sig2650/Voltmace-Database-hardware/README.md

# Voltmace-Database-hardware
Schematics, drawings, photos of the Voltmace Database
