sig2650/Voltmace-Database-hardware/Database_schematic_A4.pdf

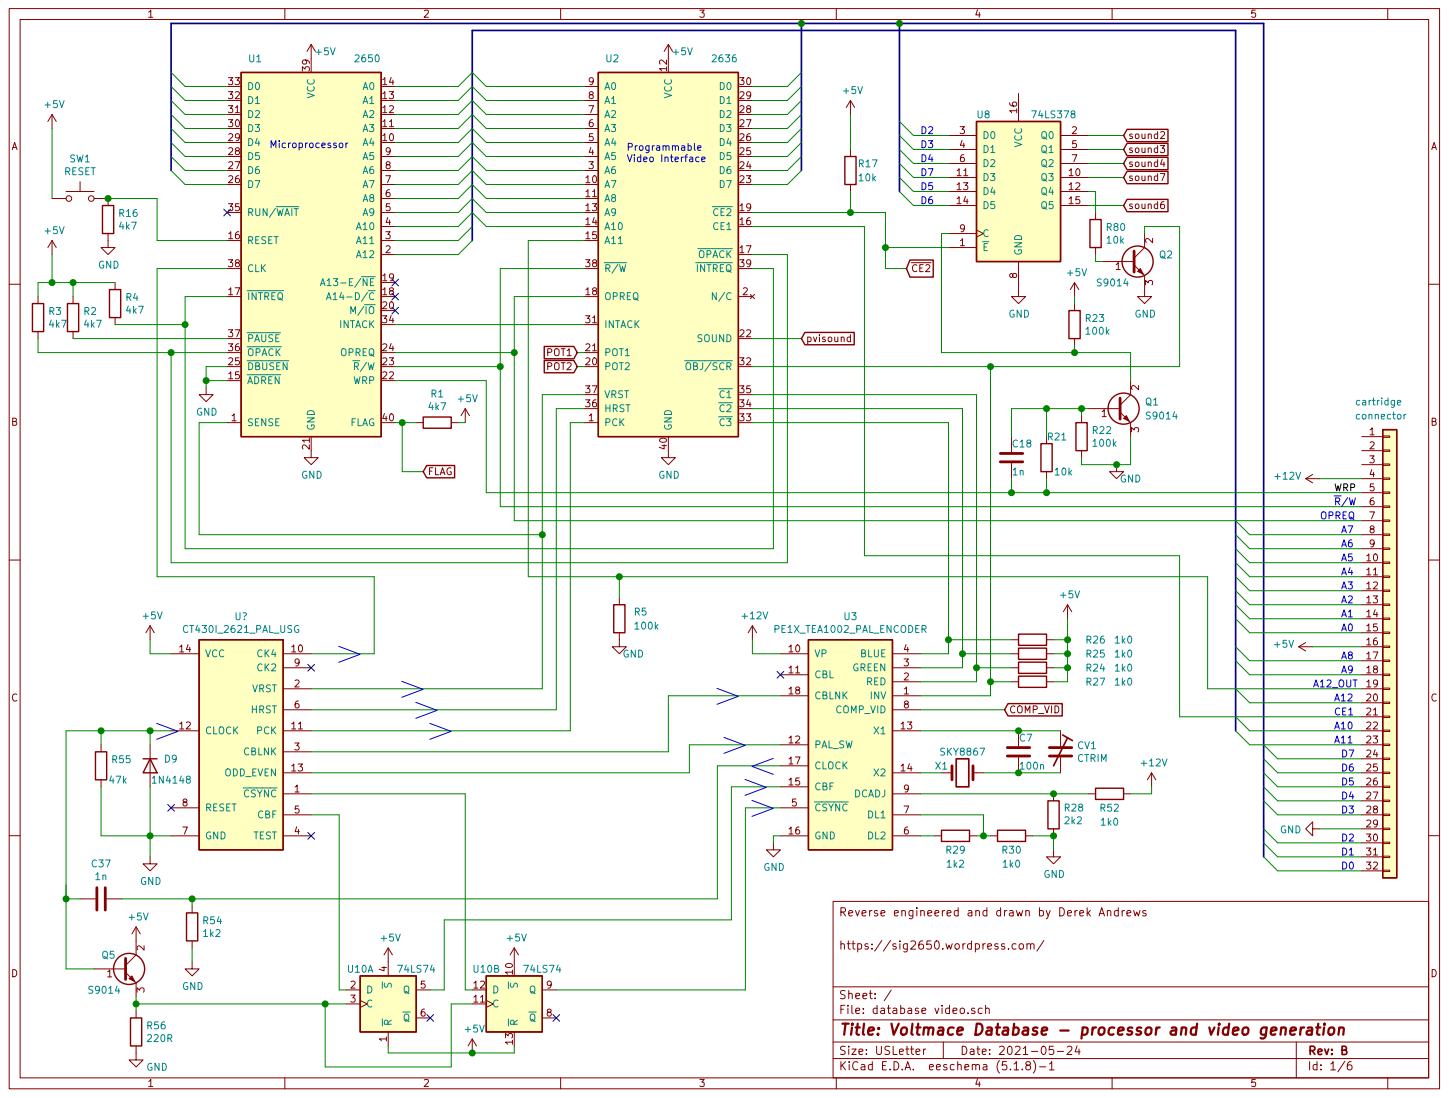
[picture p1: page 1]

Reverse engineered and drawn by Derek Andrews Sheet: Munch&CrunchCart File: munchcrunch.sch Sheet: userI0 File: userIO.sch Sheet: audio & video File: audio_video.sch Sheet: power

A12_OUT D7 R/W A7 A10 CE1 A12A6A5A4D6 8 9 10 11 12 13 14 15 16

File: database video.sch Sheet: / https://sig2650.wordpress.com/

Id: 1/6 Title: Voltmace Database - processor and video generation

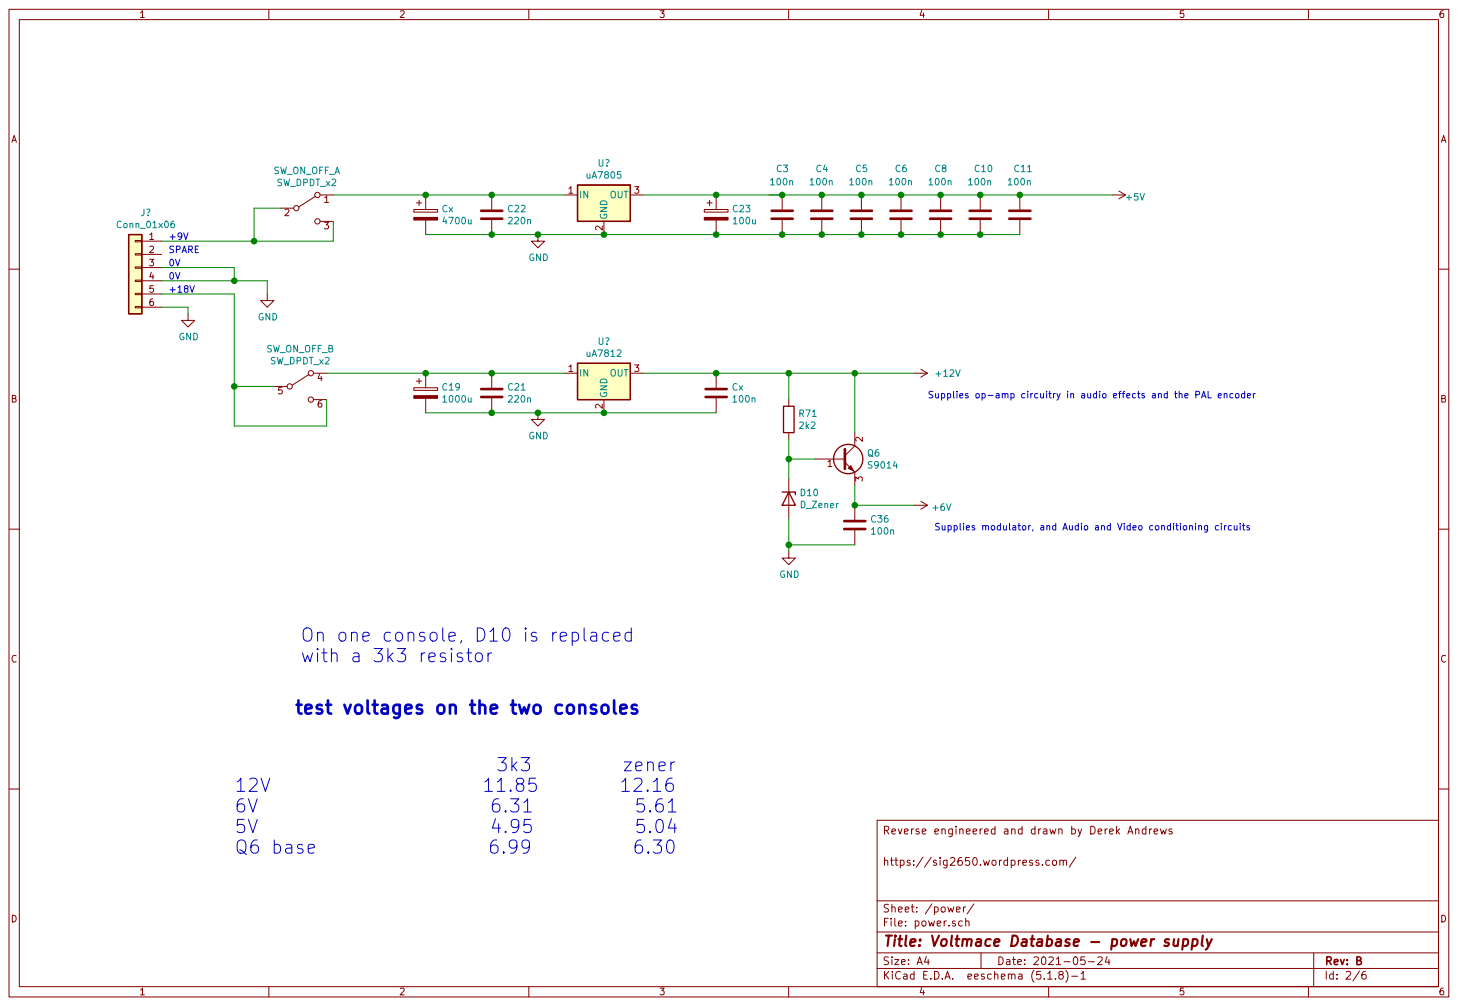
[picture p2: page 2]

Reverse engineered and drawn by Derek Andrews Cx100n GND

Supplies op-amp circuitry in audio effects and the PAL encoder

Supplies modulator, and Audio and Video conditioning circuits

On one console, D10 is replaced
with a 3k3 resistor

test voltages on the two consoles

Sheet: /power/
File: power.sch
Id: 2/6 Title: Voltmace Database - power supply

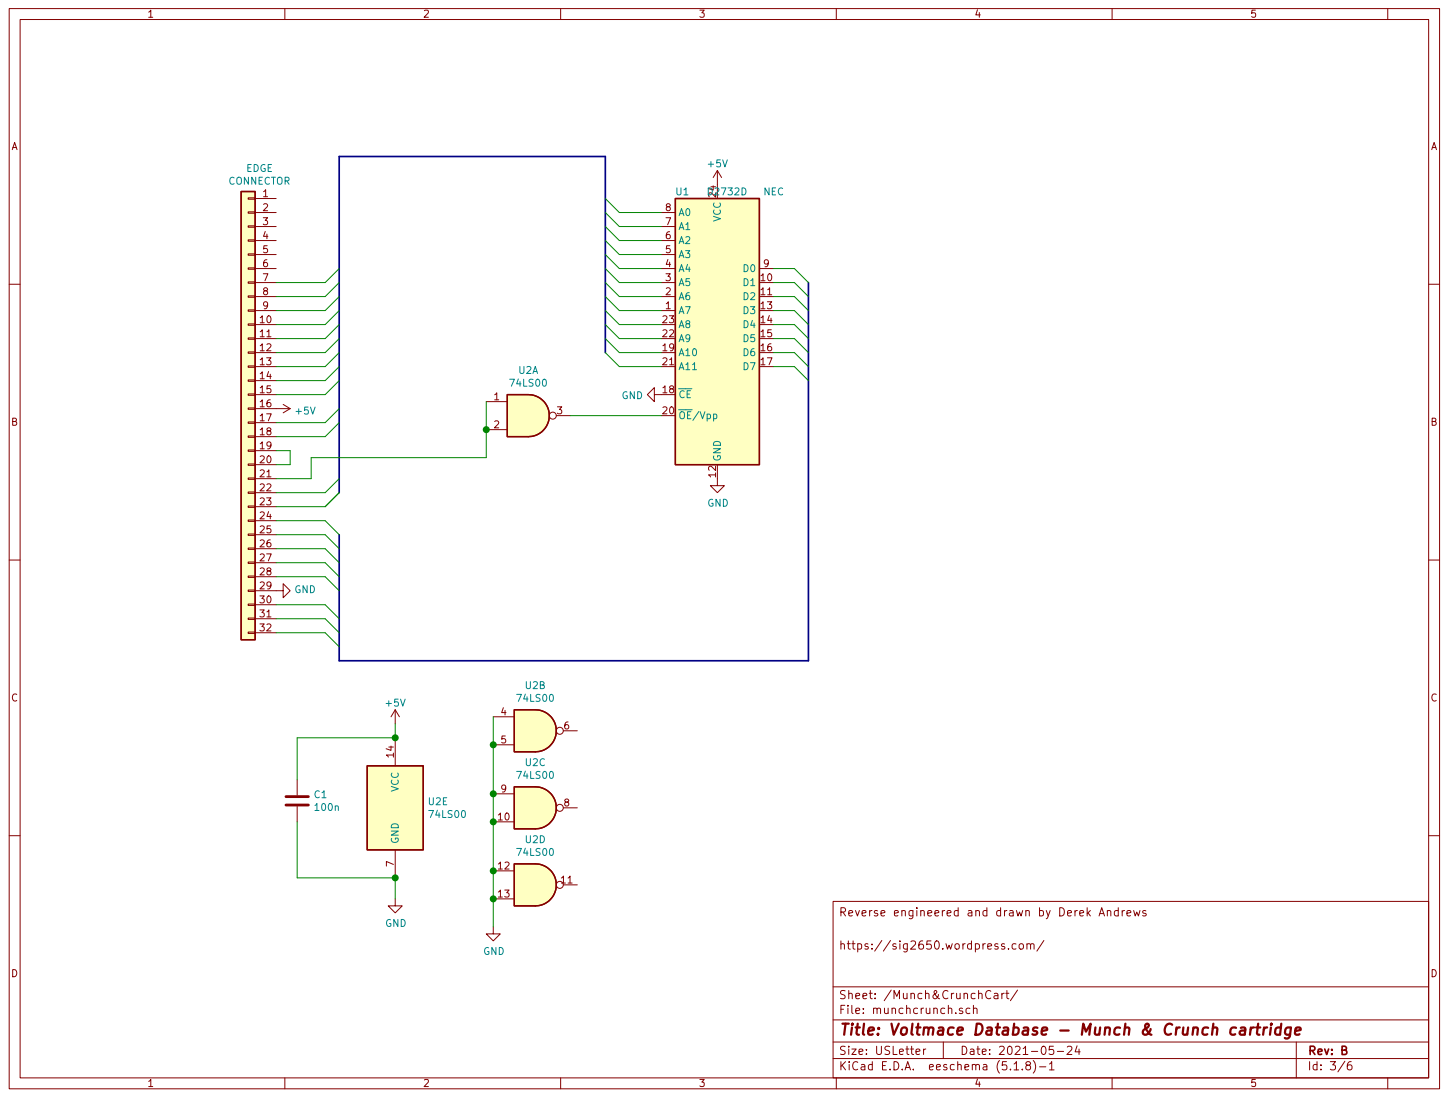
[picture p3: page 3]

Reverse engineered and drawn by Derek Andrews

File: munchcrunch.sch Sheet: /Munch&CrunchCart/ https://sig2650.wordpress.com/

Id: 3/6 Title: Voltmace Database - Munch & Crunch cartridge

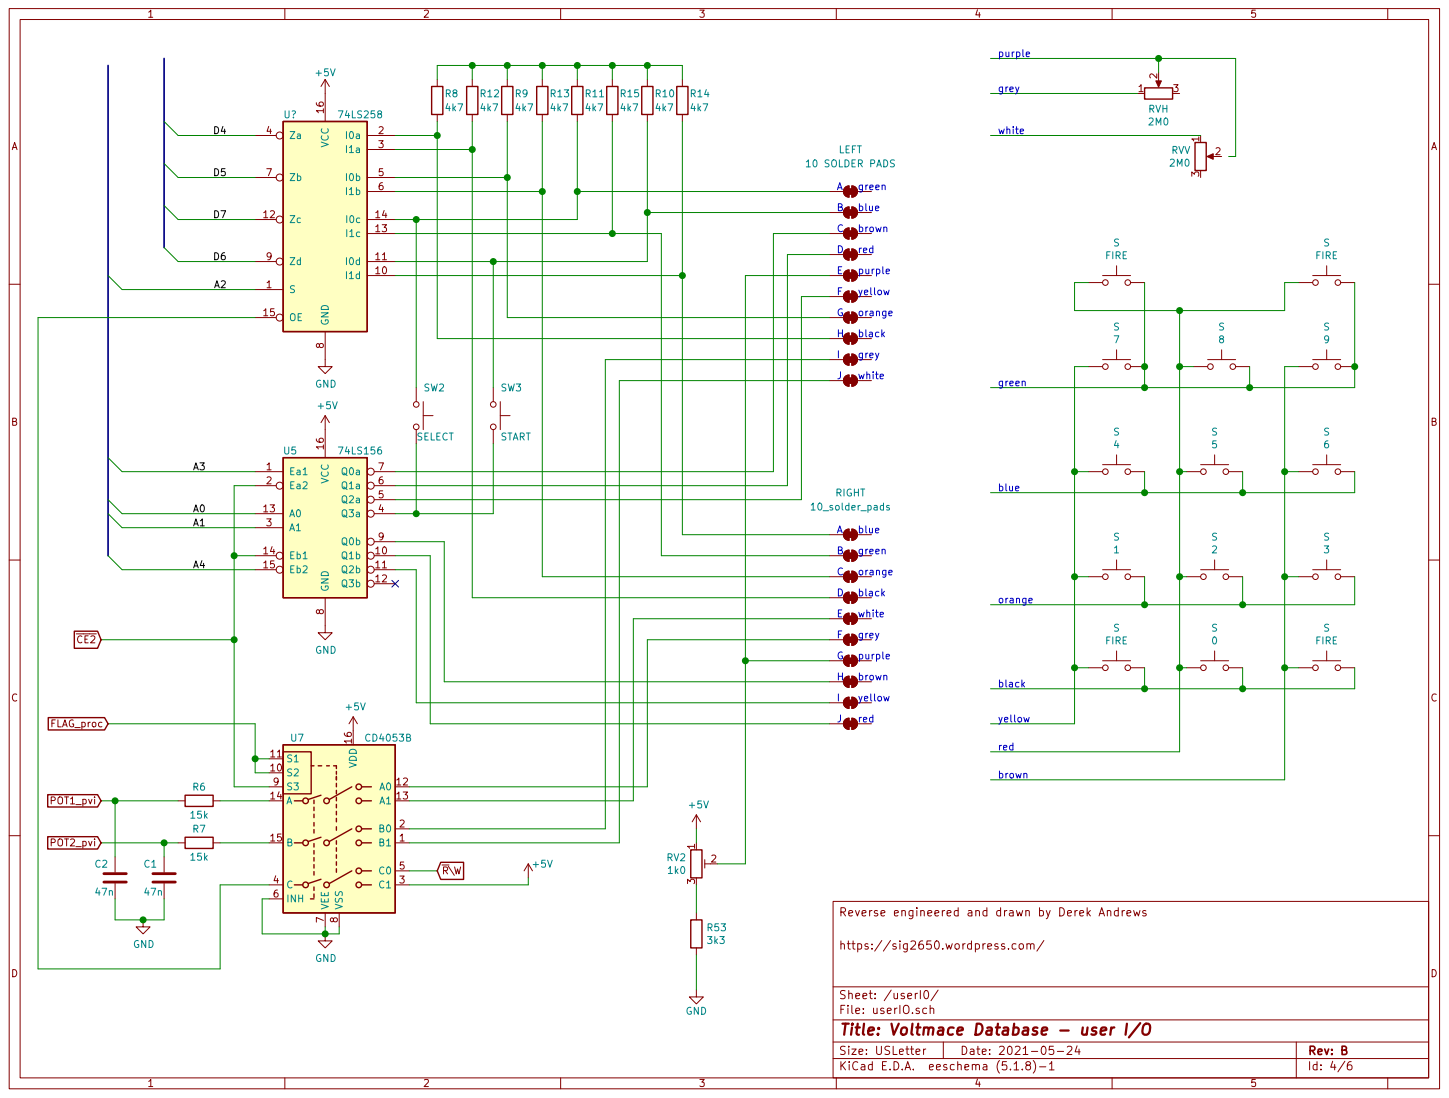
[picture p4: page 4]

Reverse engineered and drawn by Derek Andrews GND

File: userIO.sch Sheet: /userI0/ https://sig2650.wordpress.com/

Id: 4/6 Title: Voltmace Database - user I/O

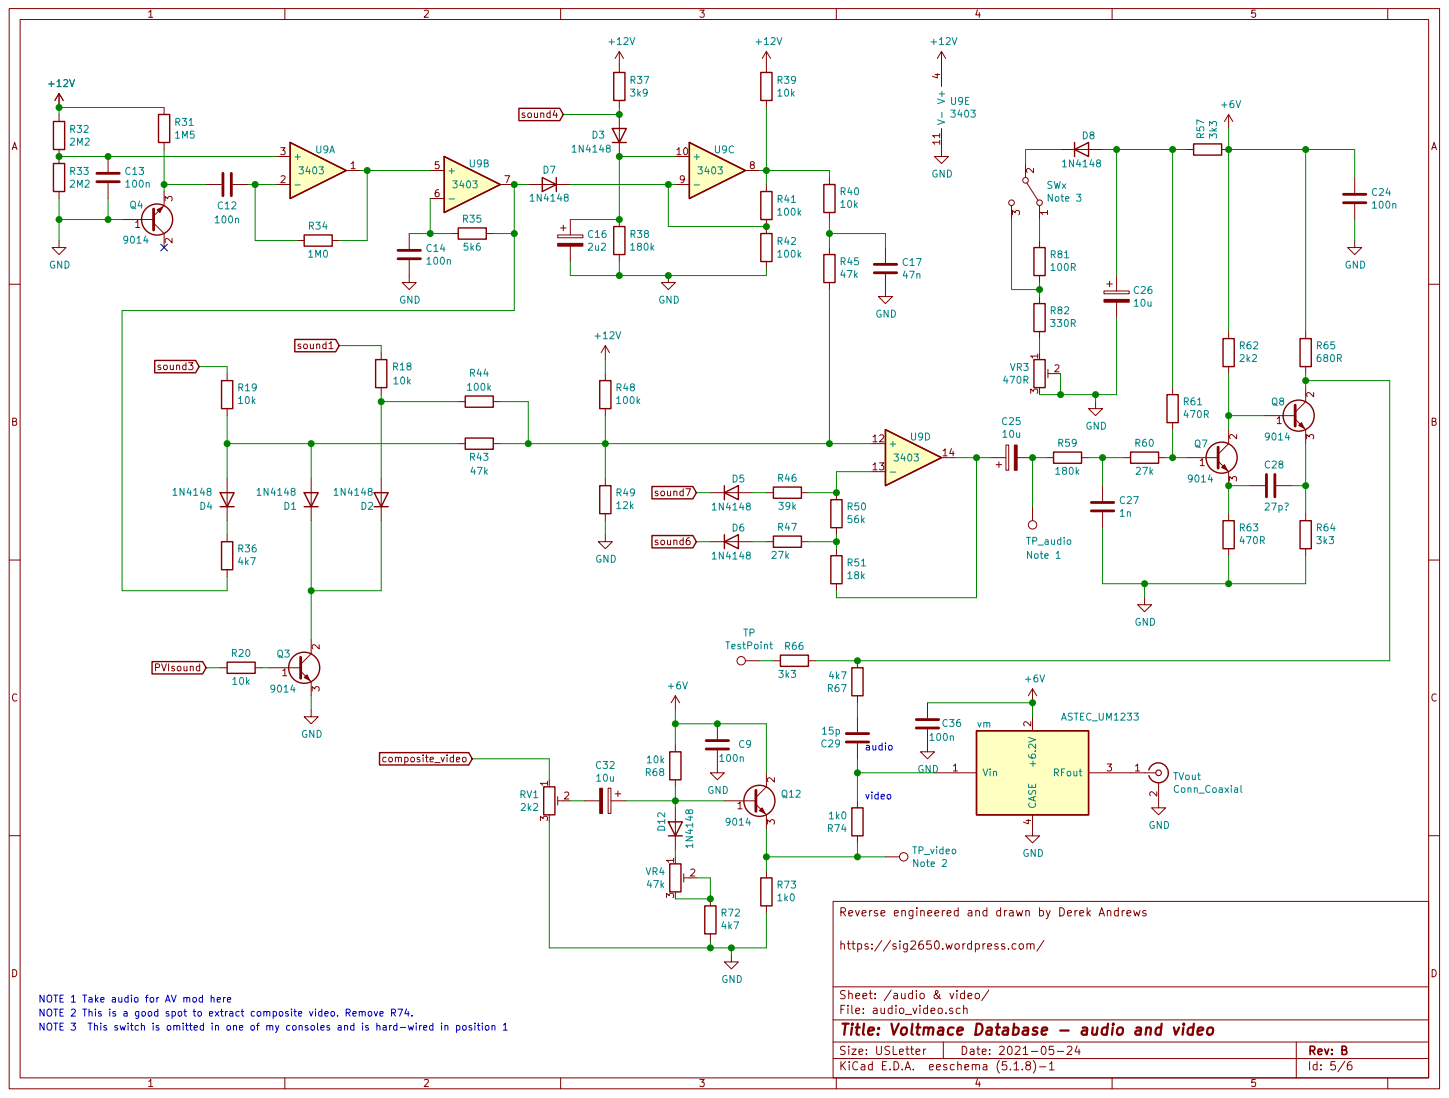
[picture p5: page 5]

Reverse engineered and drawn by Derek Andrews R66

File: audio_video.sch Sheet: /audio & video/ https://sig2650.wordpress.com/

NOTE 2 This is a good spot to extract composite video. Remove R74. NOTE 1 Take audio for AV mod here NOTE 3 This switch is omitted in one of my consoles and is hard-wired in position 1

Id: 5/6 Title: Voltmace Database - audio and video

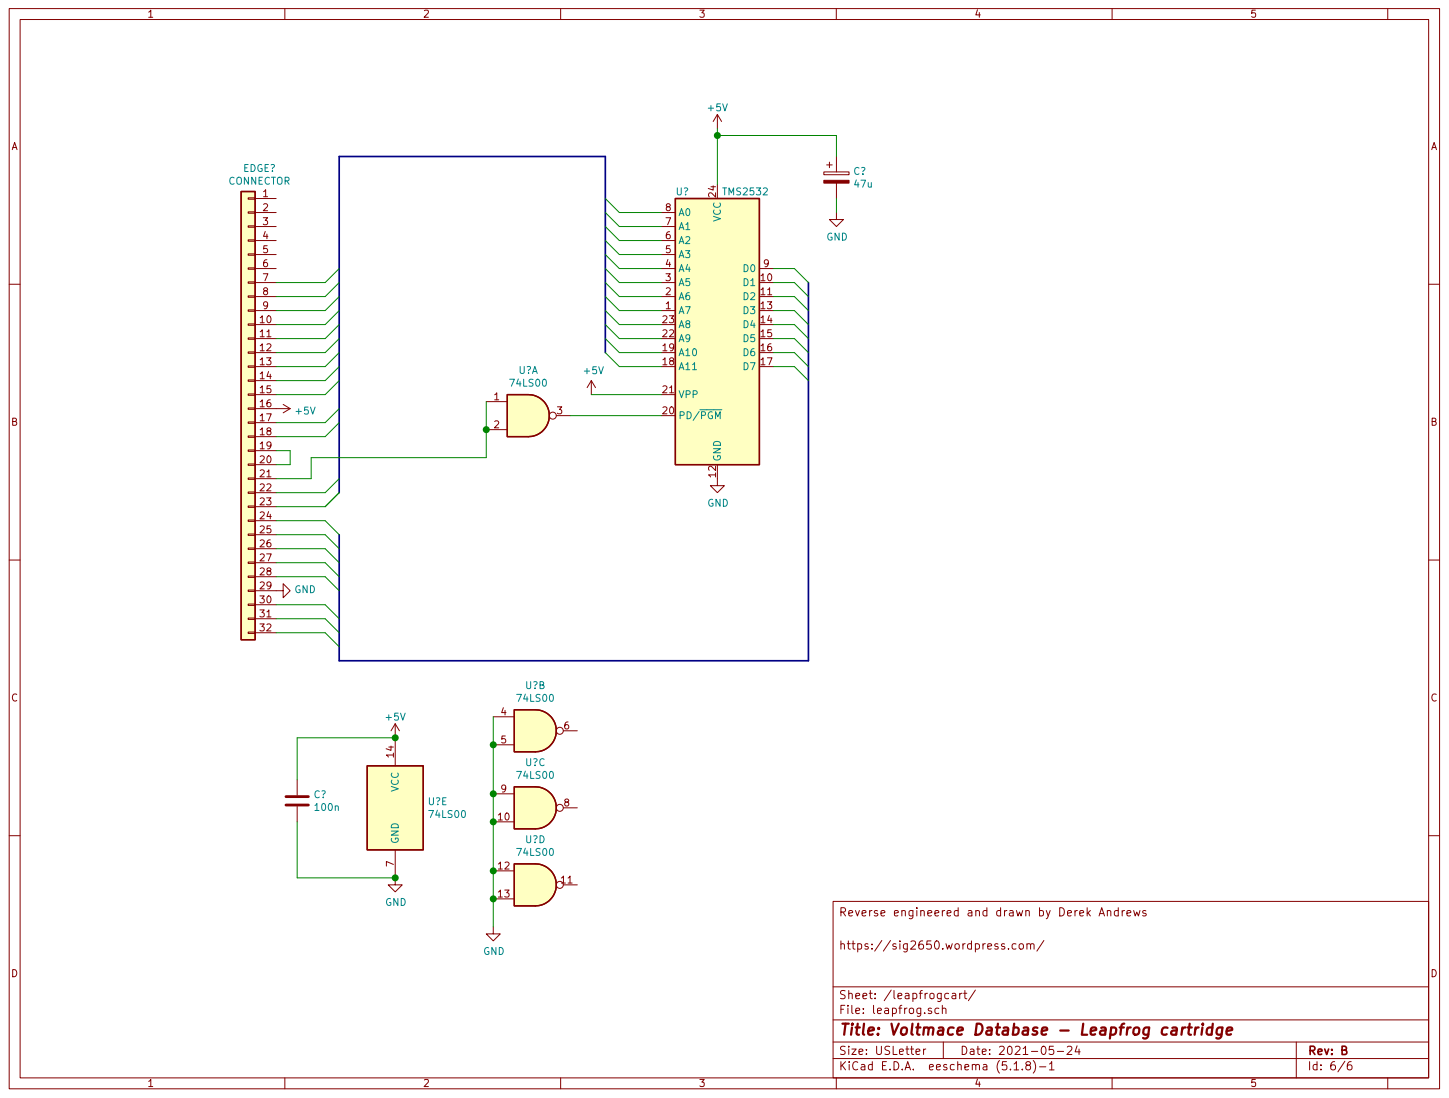
[picture p6: page 6]

Reverse engineered and drawn by Derek Andrews 1

Sheet: /leapfrogcart/
File: leapfrog.sch
Id: 6/6 Title: Voltmace Database - Leapfrog cartridge
