sig2650/Voltmace-Database-hardware/database video.sch

## KiCad design database video.sch (2021-05-08, last stored version)

Schematic: database video.sch

Parts:
C7: 100n
C18, C37: 1n
CV1: CTRIM
D9: 1N4148; D_DO-35_SOD27_P7.62mm_Horizontal
Q1, Q2, Q5: S9014
R1, R2, R3, R4, R16: 4k7
R5, R22, R23: 100k
R17, R21, R80: 10k
R24, R25, R26, R27, R30, R52: 1k0
R28: 2k2
R29, R54: 1k2
R55: 47k
R56: 220R
SW1: RESET
U1: 2650; DIP-40_W15.24mm
U2: 2636
U3: PE1X_TEA1002_PAL_ENCODER
U8: 74LS378
U10: 74LS74
X1: SKY8867
connector: cartridge

Notes on the sheet:
~R~/W
OPREQ
A12_OUT
A12
CE1
A10
A11
Microprocessor
Programmable Video Interface
