sig2650/Voltmace-Database-hardware/(commit log)

2021-05-08 Add files via upload
    Rev A, 8 May 2021. Add missing capacitor IDs and values.
2021-05-08 Delete schematicA4.pdf
    delete initial version
2021-05-08 Add files via upload
    KiCad schematic
    [database video.sch]
